mholling/rpi900/rpi900.brd

## EAGLE design rpi900.brd (2013-06-03)

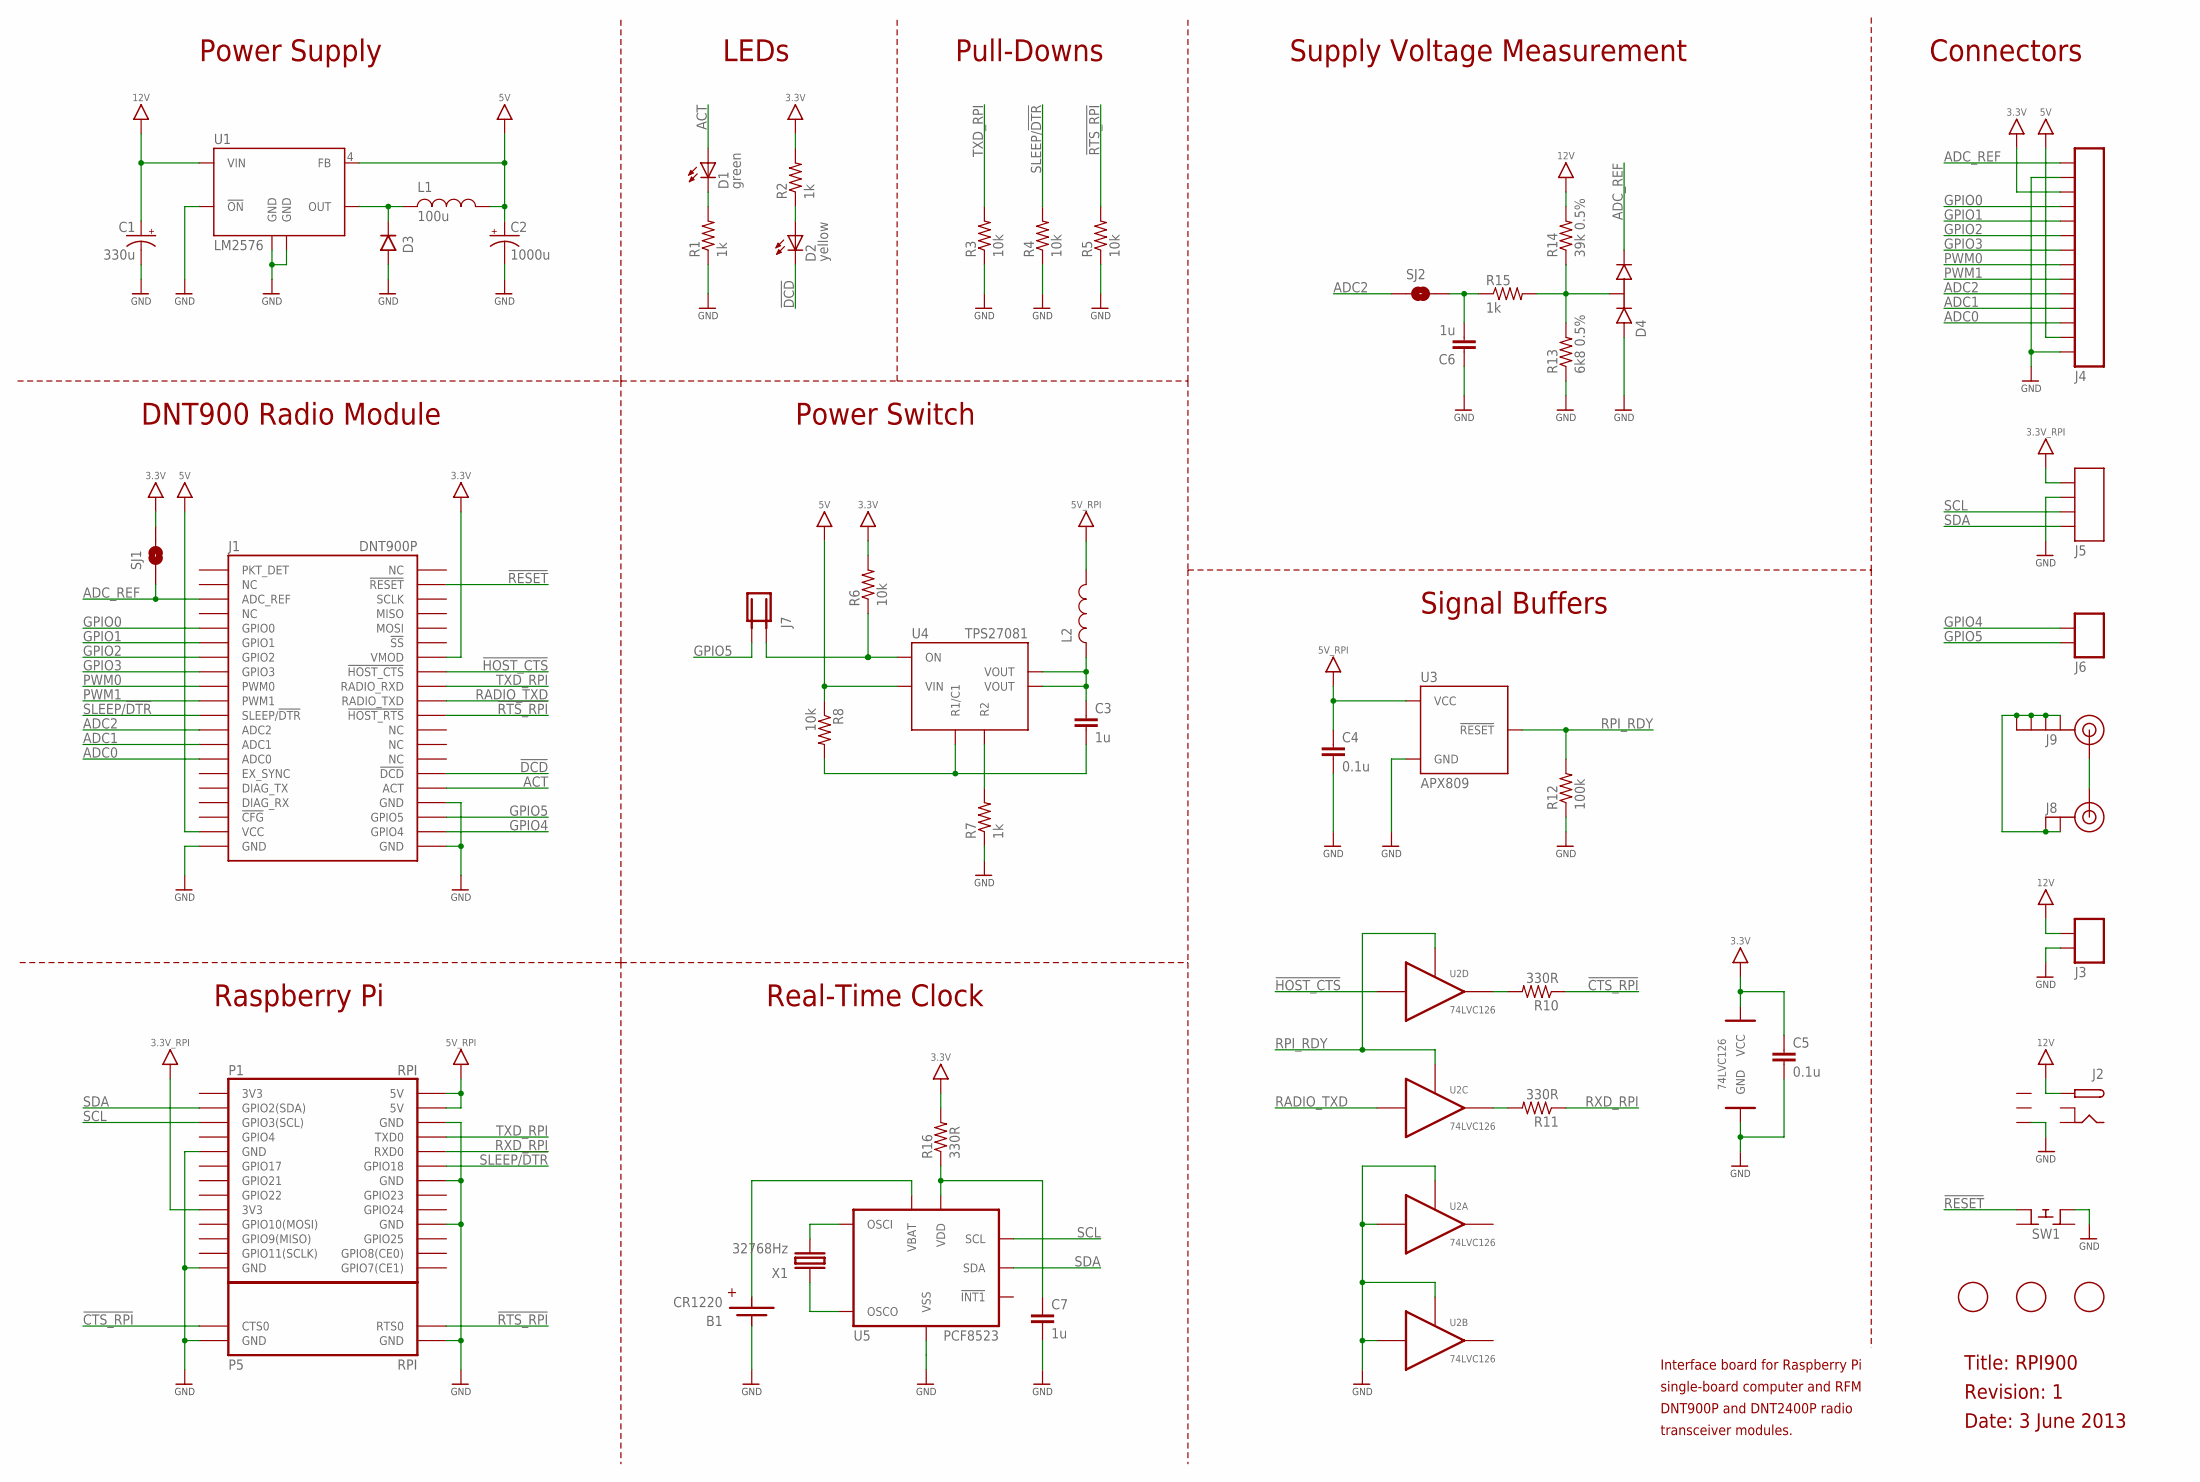
[picture p1: schematic rpi900.sch]

Parts:
B1: CR1220; 3000
C1: 330u; 140CLH-1010
C2: 1000u; 140CLH-1010
C3, C6, C7: 1u; 0805
C4, C5: 0.1u; 0805
D1: green; 0805-LED
D2: yellow; 0805-LED
D3: MURS320T3G; DO-214AB
D4: BAT54S; SOT23
F1, F2, F3: FIDUCIAL; FIDUCIAL_1MM
J1: DNT900P
J2: DCBARRELPTH; PJ-002A
J3: TERMINAL-2P-3.5MM
J4: TERMINAL-14P; TERMINAL-14P-0.1
J5: TERMINAL-4P; TERMINAL-4P-0.1
J6: TERMINAL-2P-0.1
J7: JUMPER
J8: U.FL
J9: SMAPTH; SMA-PTH
L1: 100u; SRR1280
L2: FERRITE-BEAD; 0805
P: RPI
R1, R2, R7, R15: 1k; 0805
R3, R4, R5, R6, R8: 10k; 0805
R10, R11, R16: 330R; 0805
R12: 100k; 0805
R13: 6k8 0.5%; 0805
R14: 39k 0.5%; 0805
SJ1: SOLDERJUMPERTRACE; SJ_2S-TRACE
SJ2: SOLDERJUMPERNO; SJ_2S-NO
SW1: FSM4JH; JSM4JH
U1: LM2576; TO-263
U2: 74LVC126; SO14
U3: APX809; SOT23
U4: TPS27081; TSOT-23-6
U5: PCF8523; SO08
X1: 32768Hz; CFS-206

Connections:
3.3V: C5.1, J1.P$34 (VMOD), J4.3, R2.2, R6.2, R16.2, SJ1.2, U2.14 (VCC)
3.3V_RPI: J5.1, P.P$17 (3V3)
3V3: P.P$1 (3V3)
5V: C2.+, J1.P$19 (VCC), J4.13, L1.P$2, R8.1, U1.4 (FB), U4.P$4 (VIN)
5V_RPI: C4.1, L2.2, P.P$2 (5V), P.P$4 (5V), U3.P$3 (VCC)
12V: C1.+, J2.CENTRE, J3.P$1, R14.2, U1.1 (VIN)
!CTS_RPI: P.P$31 (CTS0), R10.1
!DCD: D2.K (C), J1.P$26 (!DCD)
!HOST_CTS: J1.P$33 (!HOST_CTS), U2.12 (X)
!RESET: J1.P$39 (!RESET), SW1.P$3 (3)
!RTS_RPI: J1.P$30 (!HOST_RTS), P.P$32 (RTS0), R5.2
ACT: D1.A, J1.P$25 (ACT)
ADC0: J1.P$14 (ADC0), J4.12
ADC1: J1.P$13 (ADC1), J4.11
ADC2: J1.P$12 (ADC2), J4.10, SJ2.1
ADC_REF: D4.P$2, J1.P$3 (ADC_REF), J4.1, SJ1.1
CENTRE-BOTTOM: J2.CENTRE-BOTTOM
EN_RPI: J7.1, R6.1, U4.P$5 (ON)
GND: B1.NEGATIVE, C1.-, C2.-, C4.2, C5.2, C6.1, C7.2, D3.A, D4.P$1, J1.P$20 (GND), J1.P$21 (GND), J1.P$24 (GND), J2.SLEEVE-BOTTOM, J3.P$2, J4.2, J4.14, J5.2, P.P$6 (GND), P.P$9 (GND), P.P$14 (GND), P.P$20 (GND), P.P$25 (GND), P.P$33 (GND), P.P$34 (GND), R1.1, R3.1, R4.1, R5.1, R7.1, R12.1, R13.1, SW1.P$1 (1), U1.3 (GND), U1.5 (!ON), U1.TAB (GND), U2.1 (!OE), U2.2 (X), U2.4 (!OE), U2.5 (X), U2.7 (GND), U3.P$1 (GND), U5.4 (VSS)
GPIO0: J1.P$5 (GPIO0), J4.4
GPIO1: J1.P$6 (GPIO1), J4.5
GPIO2: J1.P$7 (GPIO2), J4.6
GPIO3: J1.P$8 (GPIO3), J4.7
GPIO4: J1.P$22 (GPIO4), J6.1
GPIO5: J1.P$23 (GPIO5), J6.2, J7.2
unnamed: D1.K (C), R1.2
unnamed: D2.A, R2.1
unnamed: D4.P$3, R13.2, R14.1, R15.2
unnamed: R10.2, U2.11 (Y)
unnamed: J8.P$3 (SIGNAL), J9.SIG (SIGNAL)
unnamed: R11.2, U2.8 (Y)
unnamed: C6.2, R15.1, SJ2.2
unnamed: R7.2, U4.P$1 (R2)
unnamed: U5.1 (OSCI), X1.P$2
unnamed: J8.P$1 (GND), J8.P$2 (GND), J9.GND@0 (GND), J9.GND@1 (GND), J9.GND@2 (GND), J9.GND@3 (GND)
unnamed: C7.1, R16.1, U5.8 (VDD)
unnamed: U5.2 (OSCO), X1.P$1
OUT: D3.K, L1.P$1, U1.2 (OUT)
PWM0: J1.P$9 (PWM0), J4.8
PWM1: J1.P$10 (PWM1), J4.9
R1/C1: C3.2, R8.2, U4.P$6 (R1/C1)
RADIO_TXD: J1.P$31 (RADIO_TXD), U2.9 (X)
RPI_RDY: R12.2, U2.10 (!OE), U2.13 (!OE), U3.P$2 (!RESET)
RXD_RPI: P.P$10 (RXD0), R11.1
SCL: J5.3, P.P$5 (GPIO3(SCL)), U5.6 (SCL)
SDA: J5.4, P.P$3 (GPIO2(SDA)), U5.5 (SDA)
SHUNT: J2.SHUNT
SHUNT-BOTTOM: J2.SHUNT-BOTTOM
SLEEP/!DTR: J1.P$11 (SLEEP/!DTR), P.P$12 (GPIO18), R4.2
SLEEVE: J2.SLEEVE
TXD_RPI: J1.P$32 (RADIO_RXD), P.P$8 (TXD0), R3.2
VBAT: B1.POSITIVE1 (POSITIVE), U5.3 (VBAT)
VOUT: C3.1, L2.1, U4.P$2 (VOUT), U4.P$3 (VOUT)

Notes on the sheet:
Power Supply
DNT900 Radio Module
Raspberry Pi
Real-Time Clock
Power Switch
LEDs
Connectors
Signal Buffers
Supply Voltage Measurement
Pull-Downs
Revision: 1
Title: RPI900
Interface board for Raspberry Pi
Date: 3 June 2013
single-board computer and RFM
DNT900P and DNT2400P radio
transceiver modules.

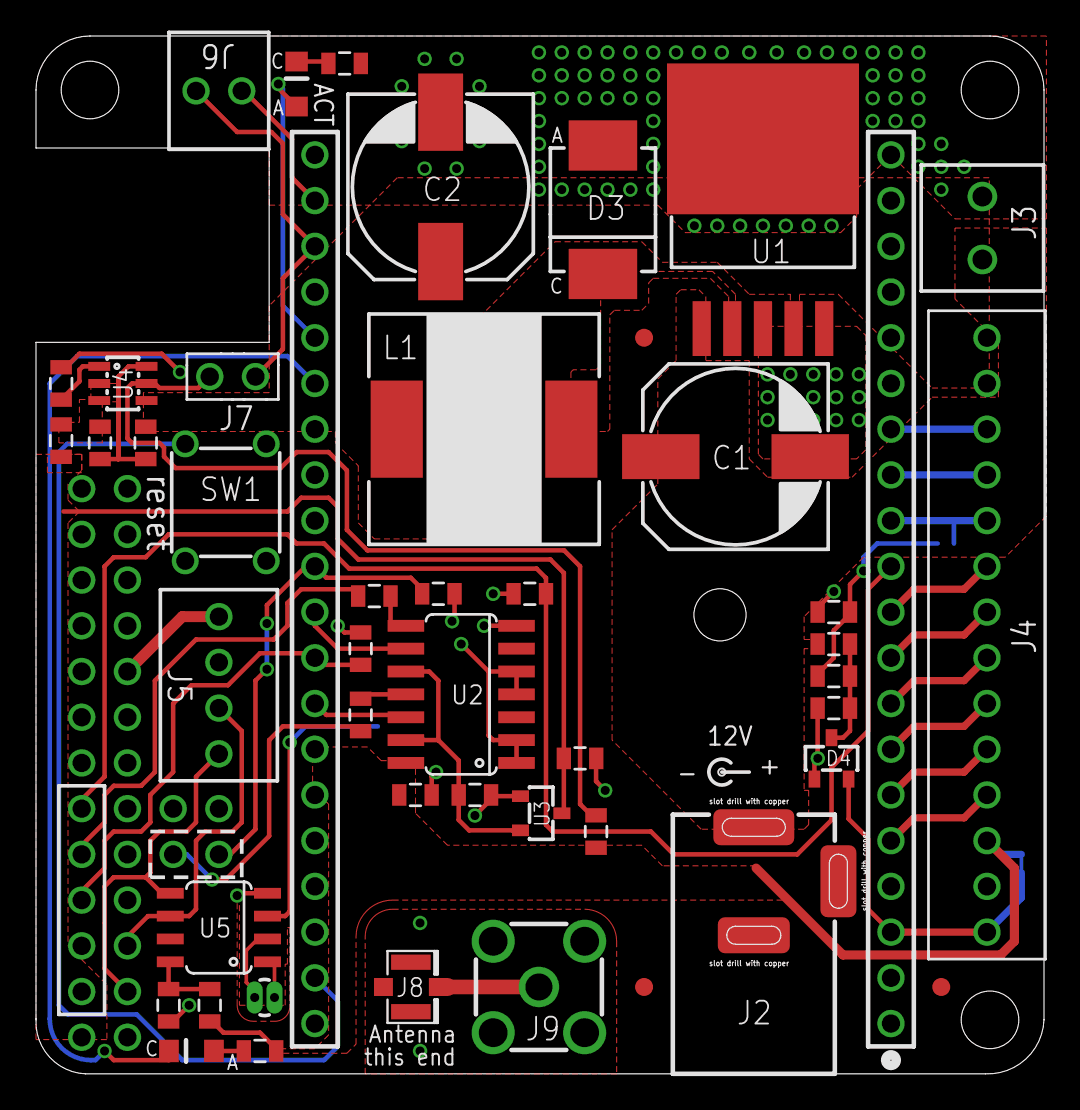
[picture p2: board rpi900.brd from above]

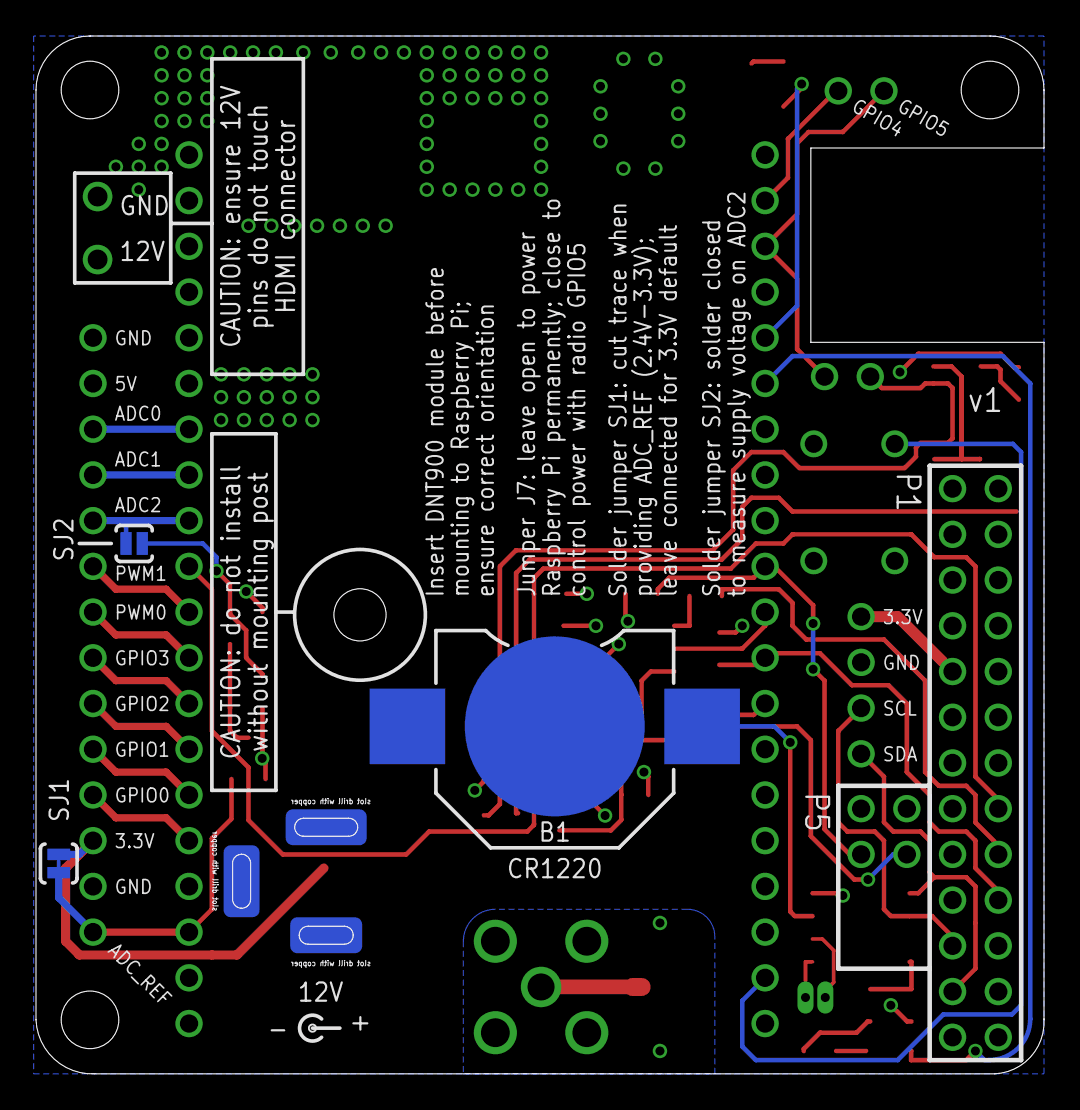
[picture p3: board rpi900.brd from below]

Board: 2 copper layers, 56.0 x 57.7 mm, 54 parts (3 on the bottom side), 48 nets.

Other parts of the board:
U$9, U$28, U$46: CORNER-SHARP
