mholling/rpi900/(commit log)

2013-06-03 adding files for revision 1 hardware
    [bom.csv, rpi900.brd, rpi900.sch]
2013-12-01 new PKGBUILD patch for linux-raspberrypi-3.10.21
2014-04-08 add PKGBUILD patch to increase UART0_CLOCK for high-speed serial
